pdaderko/lighthouse_sensor/hardware/pics/assembled_top.jpg

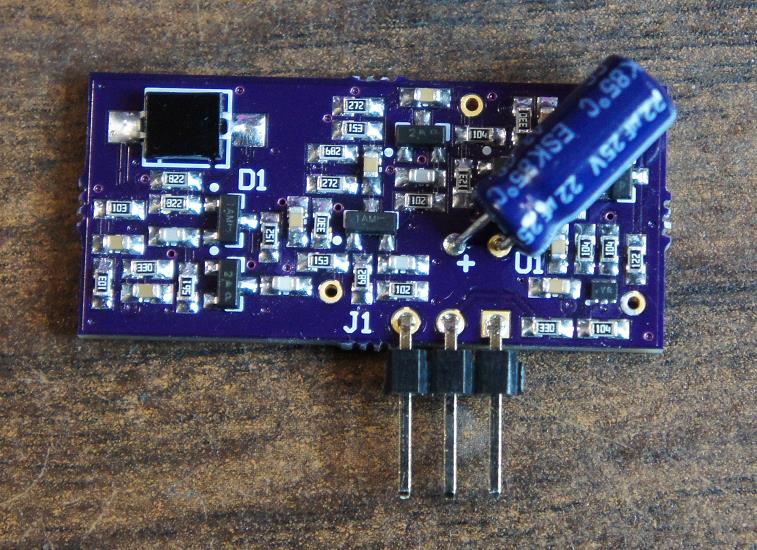
hardware/pics/assembled_top.jpg
