pdaderko/lighthouse_sensor/hardware/pics/assembled_bottom.jpg

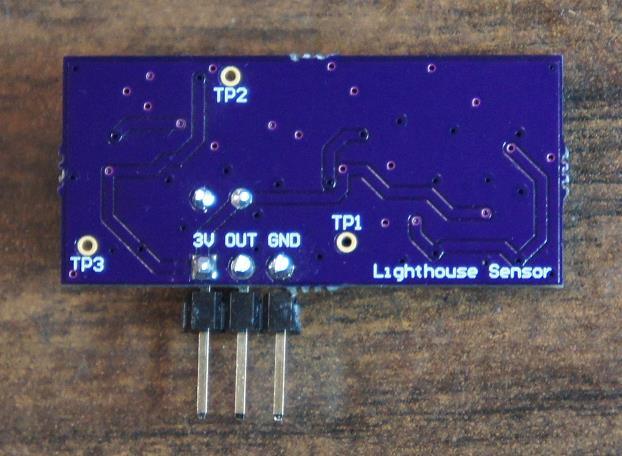
hardware/pics/assembled_bottom.jpg
