pdaderko/lighthouse_sensor/README.md

# lighthouse_sensor
Lighthouse Sensor for HTC Vive
