pdaderko/lighthouse_sensor/hardware/pics/bare_pcb.jpg

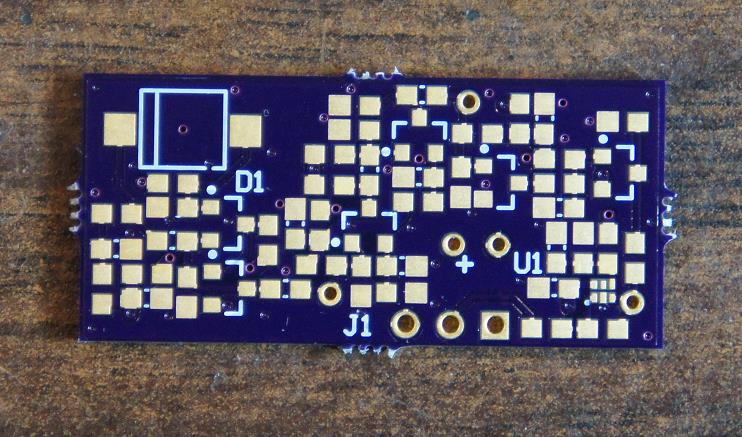
hardware/pics/bare_pcb.jpg
