pdaderko/lighthouse_sensor/hardware/Vive_Lighthouse_Sensor_BOM.xls

Designator | Quantity | Value | Manufacturer | P/N | Description
C1, C4, C5, C6, C9, C11, C12, C13 | 8 | 100nF | Kemet | C0603C104K3RACTU | 0603 Ceramic Chip Capacitor
C2, C7, C8 | 3 | 1nF | Kemet | C0603C102J3GACTU | 0603 Ceramic Chip Capacitor
C3, C10 | 2 | 100pF | Kemet | C0603C101J3GACTU | 0603 Ceramic Chip Capacitor
C14 | 1 | 22uF | Kemet | ESK226M025AC3AA | Through-hole Electrolytic Capacitor
D1 | 1 |  | Vishay | VBPW34FAS | Silicon PIN Photodiode
J1 | 1 |  | Harwin | M20-9960345 | 1x3 0.1" Through-hole Header (Right Angle)
Q1, Q3, Q5 | 3 |  | On Semi | MMBT3904LT3G | General Purpose Transistor, NPN Silicon, 3-Pin SOT-23
Q2, Q4, Q6 | 3 |  | On Semi | MMBT3906LT3G | General Purpose Transistor, PNP Silicon, 3-Pin SOT-23
R1, R2 | 2 | 10K | Panasonic | ERJ-3GEYJ103V | 0603 Thick Film Chip Resistor, 5% Tolerance
R3, R4 | 2 | 8.2K | Panasonic | ERJ-3GEYJ822V | 0603 Thick Film Chip Resistor, 5% Tolerance
R5 | 1 | 1.5K | Panasonic | ERJ-3GEYJ152V | 0603 Thick Film Chip Resistor, 5% Tolerance
R6 | 1 | 560 | Panasonic | ERJ-3GEYJ561V | 0603 Thick Film Chip Resistor, 5% Tolerance
R7, R8, R20, R27 | 4 | 33 | Panasonic | ERJ-3GEYJ330V | 0603 Thick Film Chip Resistor, 5% Tolerance
R9, R14 | 2 | 15K | Panasonic | ERJ-3GEYJ153V | 0603 Thick Film Chip Resistor, 5% Tolerance
R10, R13 | 2 | 6.8K | Panasonic | ERJ-3GEYJ682V | 0603 Thick Film Chip Resistor, 5% Tolerance
R11, R16 | 2 | 2.7K | Panasonic | ERJ-3GEYJ272V | 0603 Thick Film Chip Resistor, 5% Tolerance
R12, R15 | 2 | 1K | Panasonic | ERJ-3GEYJ102V | 0603 Thick Film Chip Resistor, 5% Tolerance
R17, R24, R25, R26 | 4 | 100K | Panasonic | ERJ-3GEYJ104V | 0603 Thick Film Chip Resistor, 5% Tolerance
R18 | 1 | 12K | Panasonic | ERJ-3GEYJ123V | 0603 Thick Film Chip Resistor, 5% Tolerance
R19, R21 | 2 | 56K | Panasonic | ERJ-3GEYJ563V | 0603 Thick Film Chip Resistor, 5% Tolerance
R22 | 1 | 5.6K | Panasonic | ERJ-3GEYJ562V | 0603 Thick Film Chip Resistor, 5% Tolerance
R23 | 1 | 1.2K | Panasonic | ERJ-3GEYJ122V | 0603 Thick Film Chip Resistor, 5% Tolerance
U1 | 1 |  | Toshiba | TC75S70L6X,LF | Single Comparator
