pdaderko/lighthouse_sensor/hardware/Vive_Lighthouse_Sensor_assy.pdf

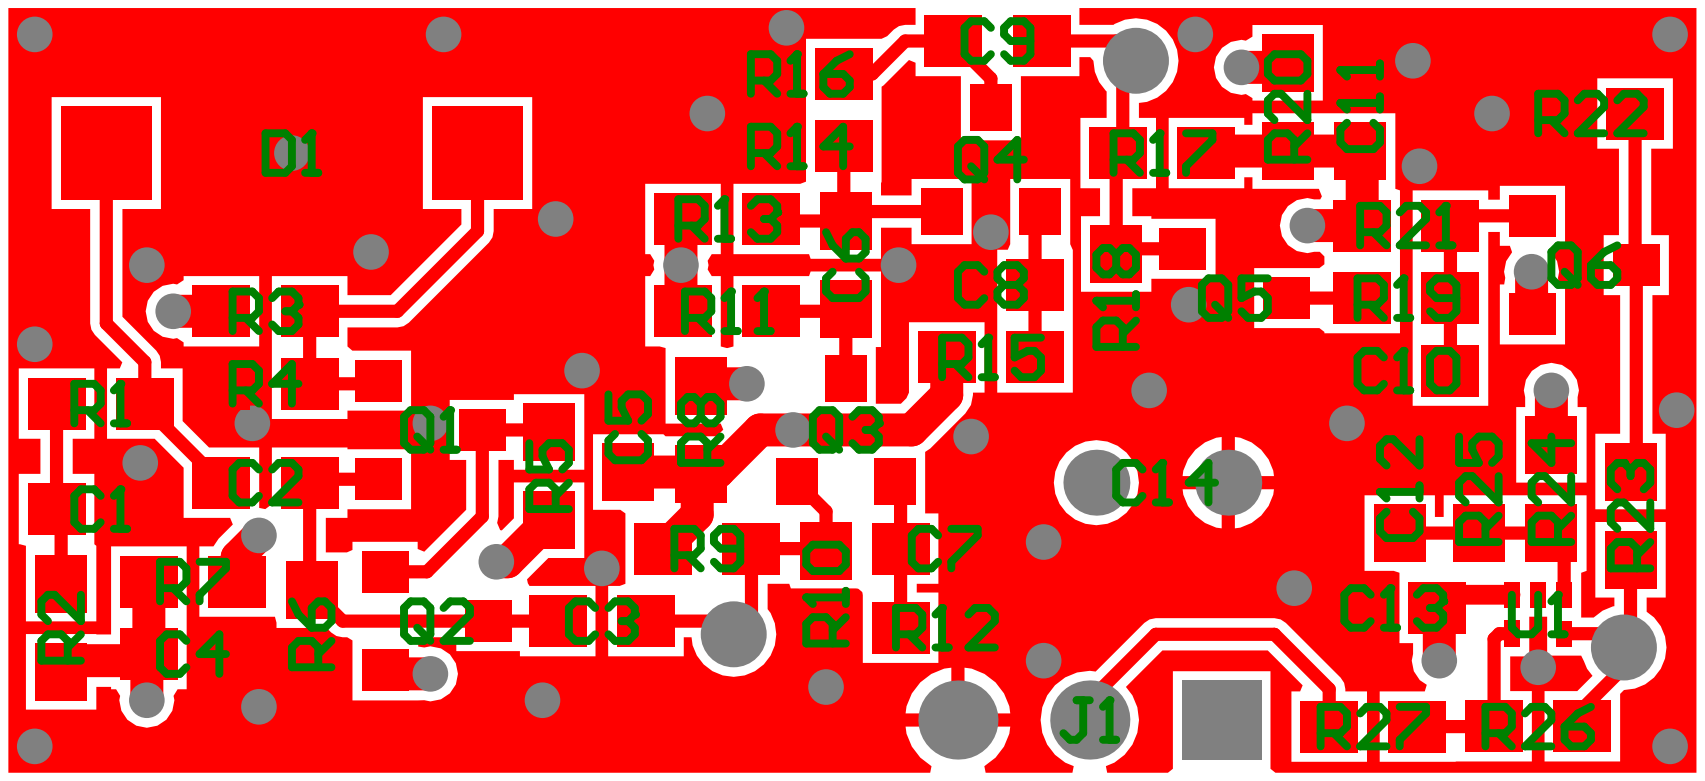
[picture p4: page 1]
