pdaderko/lighthouse_sensor/hardware/Vive_Lighthouse_Sensor_schem.pdf

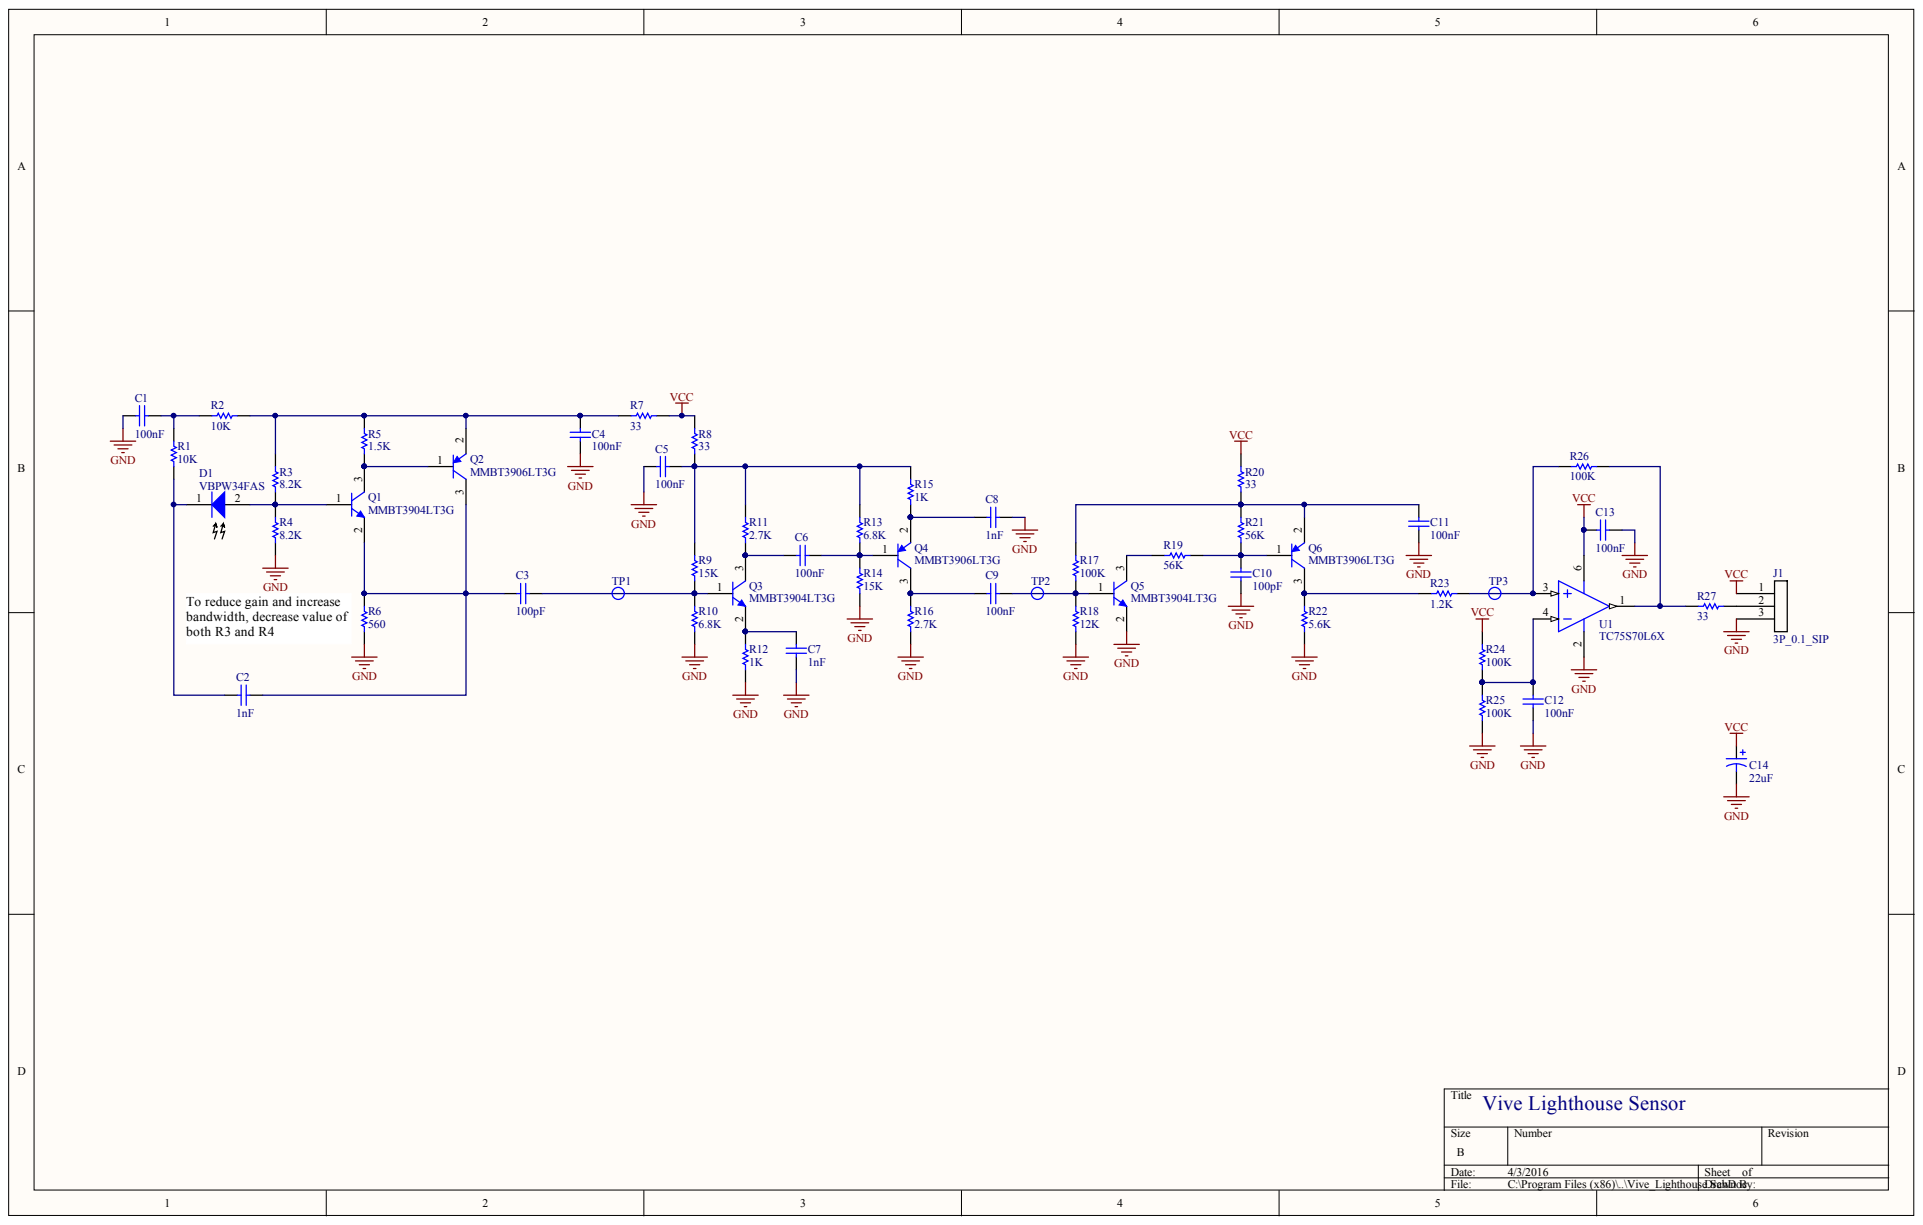
[picture p5: page 1]

To red ban d w b o t h R | uce gai i d t h , decrease 3 an d | n an d i val ue o f R 4 | D

ighthouse.SchD Drawn Bocy:
