pdaderko/lighthouse_sensor/(list of files, drawings)

Other design files:
hardware/altium/lighthouse_sensor/lighthouse_sensor.PcbDoc
hardware/altium/lighthouse_sensor/lighthouse_sensor.PcbLib
hardware/altium/lighthouse_sensor/lighthouse_sensor.PrjPCB
hardware/altium/lighthouse_sensor/lighthouse_sensor.SchDoc
hardware/altium/lighthouse_sensor/lighthouse_sensor.SCHLIB
