pdaderko/lighthouse_sensor/(commit log)

2016-04-23 Initial commit of hardware files
    [Vive_Lighthouse.GBL, Vive_Lighthouse.GBO, Vive_Lighthouse.GBS, Vive_Lighthouse.GKO, Vive_Lighthouse.GTL, Vive_Lighthouse.GTO, Vive_Lighthouse.GTS, Vive_Lighthouse.XLN]
2016-04-23 Added pick and place file for automated assembly
    [Pick Place for Vive_Lighthouse.csv]
2016-06-23 Added Altium Files
    [lighthouse_sensor.PcbDoc, lighthouse_sensor.PcbLib, lighthouse_sensor.PrjPCB, lighthouse_sensor.SCHLIB, lighthouse_sensor.SchDoc]
